nvrmchng/stepper-trinamic/test setup.jpg

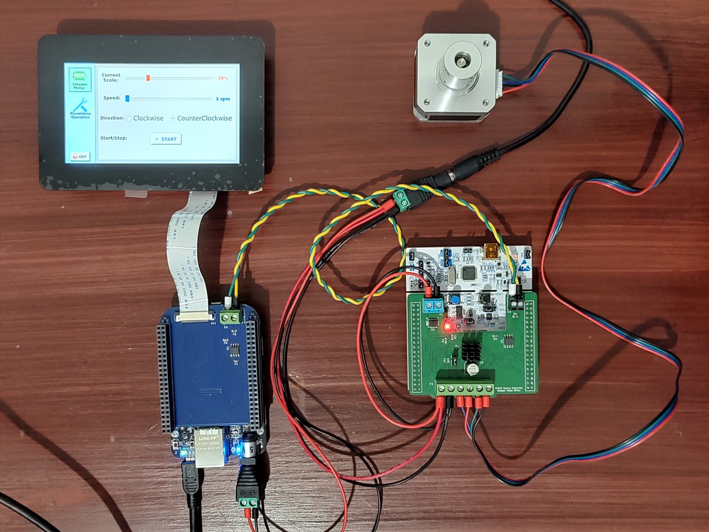
test setup.jpg
