nvrmchng/stepper-trinamic/PCB_Files/Stepper_Motor_Expansion_Brd_revA/Pictures/attached to nucleo brd.jpg

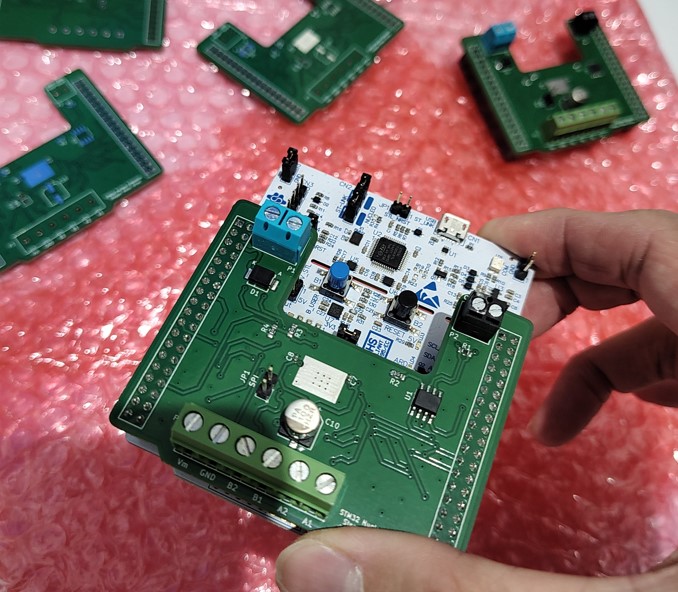
PCB_Files/Stepper_Motor_Expansion_Brd_revA/Pictures/attached to nucleo brd.jpg
