nvrmchng/stepper-trinamic/README.md

# stepper-trinamic
Driving stepper motor with TMC2130 IC from TRINAMIC Motion.
