nvrmchng/stepper-trinamic/PCB_Files/CTP_Display_CANbus_revA/Pics/attached to BBB.jpg

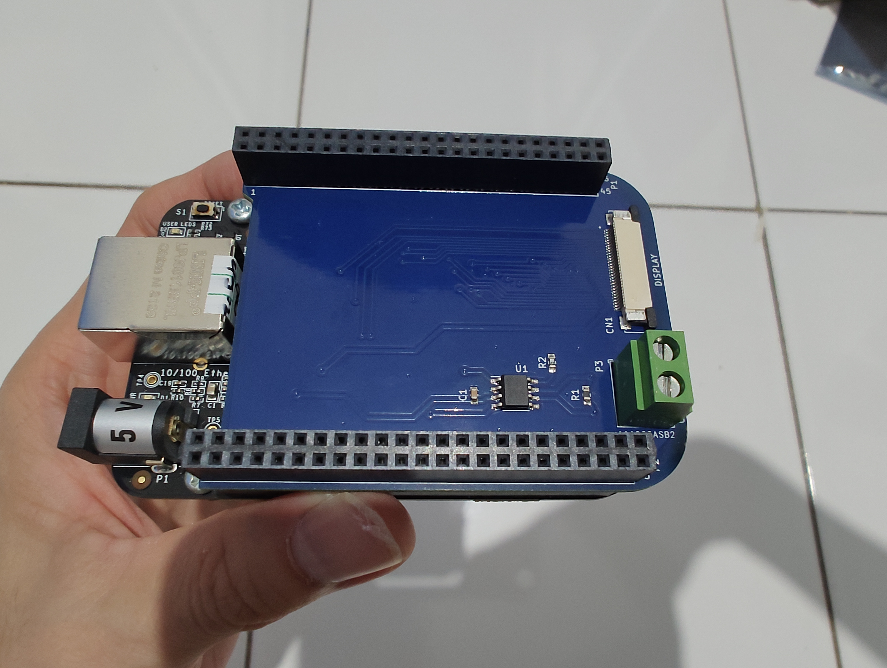
PCB_Files/CTP_Display_CANbus_revA/Pics/attached to BBB.jpg
