nvrmchng/stepper-trinamic/PCB_Files/CTP_Display_CANbus_revA/Pics/top side.jpg

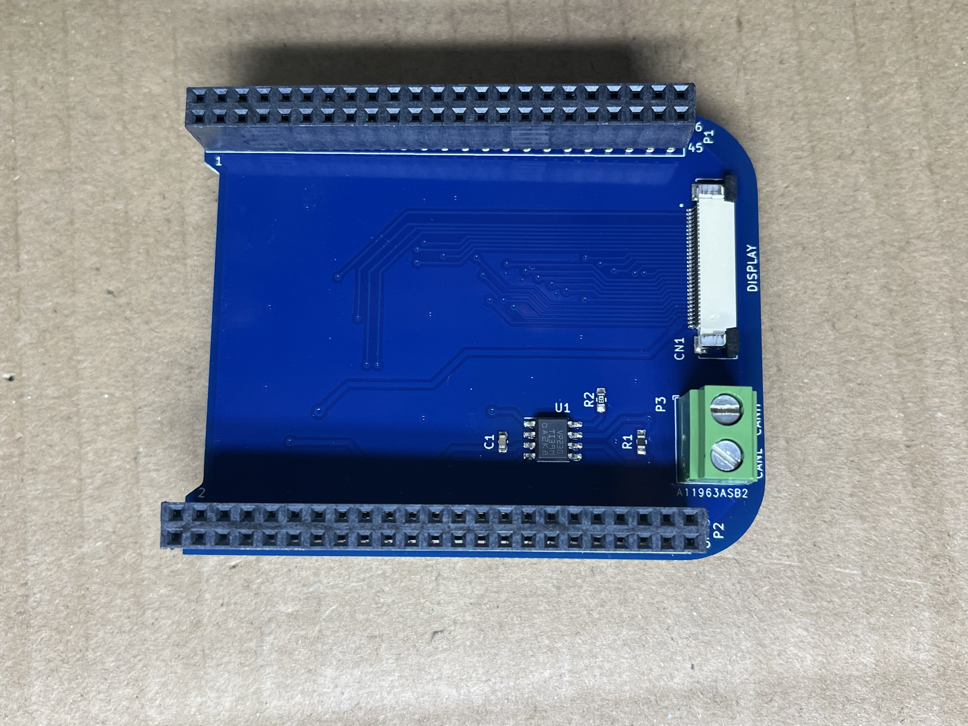
PCB_Files/CTP_Display_CANbus_revA/Pics/top side.jpg
