nvrmchng/stepper-trinamic/PCB_Files/Stepper_Motor_Expansion_Brd_revA/Pictures/bottom side.jpg

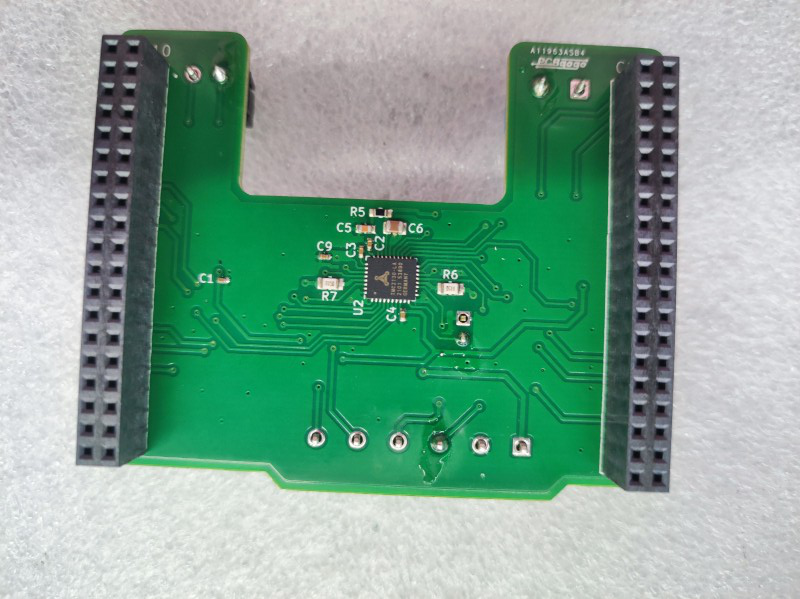
PCB_Files/Stepper_Motor_Expansion_Brd_revA/Pictures/bottom side.jpg
