nvrmchng/stepper-trinamic/PCB_Files/Stepper_Motor_Expansion_Brd_revA/Pictures/top side.jpg

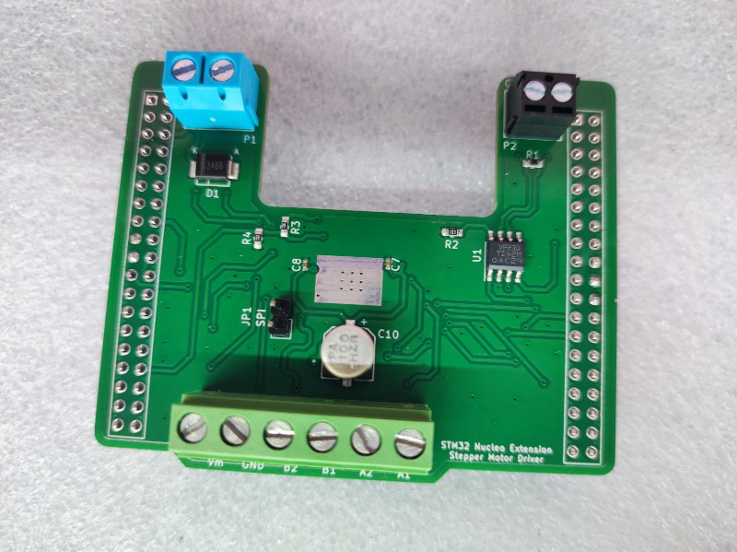
PCB_Files/Stepper_Motor_Expansion_Brd_revA/Pictures/top side.jpg
