nvrmchng/stepper-trinamic/Software ui/Screenshot 01.jpg

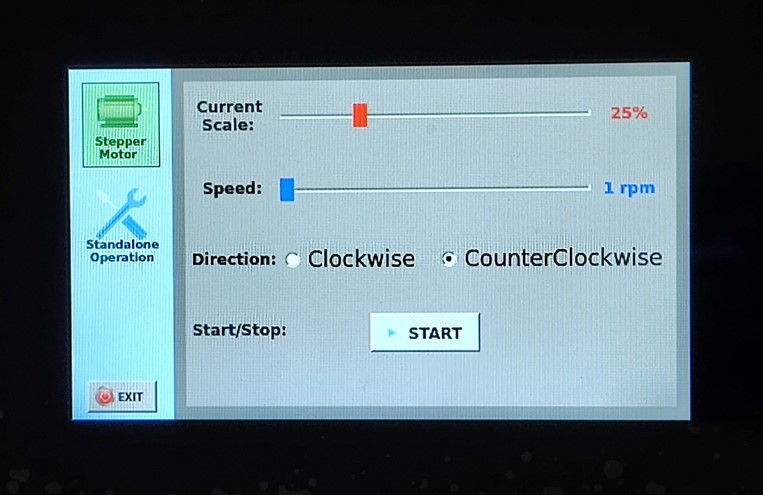
Software ui/Screenshot 01.jpg
