nvrmchng/stepper-trinamic/Software ui/Screenshot 02.jpg

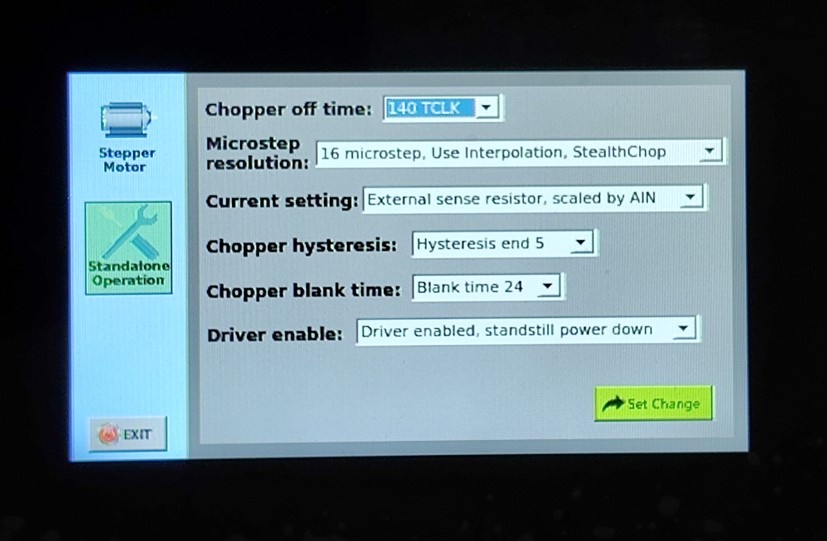
Software ui/Screenshot 02.jpg
