nvrmchng/stepper-trinamic/PCB_Files/CTP_Display_CANbus_revA/BOM_CTP_Display_CANbus_revA.xlsx

 | xxxx xxxx xxxxx xxPCS BOM (Sample Bill of Materials)
Quantity | Designator | Description | Footprint | Manufacturer | Part Number (Manufacturer) | Supplier | Buying Link as reference
1 | C1 | Capacitor Ceramic 0.1uF 50V X7R AEC-Q200 (Automotive) | 0603 (1608 Metric) | TDK Corporation | CGA3E2X7R1H104K080AA | Digikey
1 | CN1 | Conn FFC FPC 30Pos Slide Lock 0.5mm Pitch Top Contact | Surface Mount, Right Angle | Amphenol ICC (FCI) | F32Q-1A7H1-11030 | Digikey
2 | P1, P2 | Female Header Black 46Pos (2x23) 2.54mm Pitch Tin Contact | Through Hole | Samtec Inc. | SSQ-123-03-T-D | Digikey
1 | P3 | Screw Terminal Block Green 2Pos 5mm Pitch Horizontal | Through Hole | Wurth Elektronik | 691137710002 | Digikey
1 | R1 | Res 120 Ohm 1% +-100ppm 0.25W AEC-Q200 (Automotive) | 0603 (1608 Metric) | Vishay Dale | RCS0603120RFKEA | Digikey
1 | R2 | Res 10kOhm 5% +-100ppm 0.1W AEC-Q200 (Automotive) | 0603 (1608 Metric) | YAGEO | AC0603JR-0710KL | Digikey
1 | U1 | IC Transceiver CANbus 1 Mbps Half Duplex 3-3.6V Supply | SOIC-8 (3.9x4.9mm) | Texas Instruments | SN65HVD230DR | Digikey
