nvrmchng/stepper-trinamic/PCB_Files/Stepper_Motor_Expansion_Brd_revA/BOM_Stepper_Motor_Expansion_Brd_revA.xlsx

 | xxxx xxxx xxxxx xxPCS BOM (Sample Bill of Materials)
Quantity | Designator | Description | Footprint | Manufacturer | Part Number (Manufacturer) | Supplier | Buying Link as reference
6 | C1, C3, C4, C7, C8, C9 | Capacitor Ceramic 0.1uF 10% 50V X7R AEC-Q200 (Automotive) | 0402 (1005 Metric) | Murata Electronics | GCM155R71H104KE02D | Digikey | https://www.digikey.com/en/products/detail/murata-electronics/GCM155R71H104KE02D/4903704
1 | C2 | Capacitor Ceramic 22nF 10% 50V X7R AEC-Q200 (Automotive) | 0402 (1005 Metric) | KEMET | C0402C223K5RACAUTO | Digikey | https://www.digikey.com/en/products/detail/kemet/C0402C223K5RACAUTO/7516255
1 | C5 | Capacitor Ceramic 470nF 10% 25V X7R AEC-Q200 (Automotive) | 0603 (1608 Metric) | TDK Corporation | CGA3E3X7R1E474K080AB | Digikey | https://www.digikey.com/en/products/detail/tdk-corporation/CGA3E3X7R1E474K080AB/2672822
1 | C6 | Capacitor Ceramic 4.7uF 10% 25V X7R AEC-Q200 (Automotive) | 0805 (2012 Metric) | TDK Corporation | CGA4J1X7R1E475K125AC | Digikey | https://www.digikey.com/en/products/detail/tdk-corporation/CGA4J1X7R1E475K125AC/2672860
1 | C10 | Aluminium Elco 100uF 20% 50V AEC-Q200 (Automotive) | SMD (6.60mm x 6.60mm) | Chemi-Con | EMZR500ARA101MF80G | Digikey | https://www.digikey.com/en/products/detail/chemi-con/EMZR500ARA101MF80G/5824766
2 | CN7, CN10 | Female Header Black 38Pos (2x19) 2.54mm Pitch Gold | Through Hole | Samtec Inc. | SSW-119-01-F-D | Digikey | https://www.digikey.com/en/products/detail/samtec-inc/SSW-119-01-F-D/7881204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
1 | D1 | Zener Diode 6V 5W | SMB(DO-214AA) | Comchip Technology | CZRB5340B-HF | Digikey | https://www.digikey.com/en/products/detail/comchip-technology/CZRB5340B-HF/10131663
1 | JP1 | Connector Header Male Black Vertical 2Pos 2.54mm Pitch | Through Hole | Wurth Elektronik | 61300211121 | Digikey | https://www.digikey.com/en/products/detail/w%C3%BCrth-elektronik/61300211121/4846823
1 | P1 | Screw Terminal Block Blue 2Pos 5mm Pitch Horizontal | Through Hole | CUI Devices | TB002-500-02BE | Digikey | https://www.digikey.com/en/products/detail/cui-devices/TB002-500-02BE/10064069
1 | P2 | Screw Terminal Block Black 2Pos 3.5mm Pitch Horizontal | Through Hole | On Shore Technology Inc. | OSTTE020104 | Digikey | https://www.digikey.com/en/products/detail/on-shore-technology-inc/OSTTE020104/2351816
1 | P3 | Screw Terminal Block Green 6Pos 5mm Pitch Horizontal | Through Hole | Wurth Elektronik | 691137710006 | Digikey | https://www.digikey.com/en/products/detail/w%C3%BCrth-elektronik/691137710006/6644055
1 | R1 | Res 120 Ohm 1% +-100ppm 0.25W AEC-Q200 (Automotive) | 0603 (1608 Metric) | Vishay Dale | RCS0603120RFKEA | Digikey | https://www.digikey.com/en/products/detail/vishay-dale/RCS0603120RFKEA/5868381
1 | R2 | Res 10kOhm 5% +-100ppm 0.1W AEC-Q200 (Automotive) | 0603 (1608 Metric) | YAGEO | AC0603JR-0710KL | Digikey | https://www.digikey.com/en/products/detail/yageo/AC0603JR-0710KL/2827830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
2 | R3, R4 | Res 20kOhm 1% +-50ppm 1/16W, thin film | 0603 (1608 Metric) | TE Connectivity Passive Product | CPF0603F20KC1 | Digikey | https://www.digikey.com/en/products/detail/te-connectivity-passive-product/CPF0603F20KC1/2384611
1 | R5 | Res 2.2 Ohm 1% +-100ppm 0.25W AEC-Q200 (Automotive) | 0603 (1608 Metric) | Vishay Dale | RCS06032R20FKEA | Digikey | https://www.digikey.com/en/products/detail/vishay-dale/RCS06032R20FKEA/5868187
2 | R6, R7 | Res 150mOhm 1% +-50ppm 0.5W AEC-Q200, current sense | 0805 (2012 Metric) | Susumu | KRL1220E-M-R150-F-T5 | Digikey | https://www.digikey.com/en/products/detail/susumu/KRL1220E-M-R150-F-T5/3737984
1 | U1 | IC Transceiver CANbus 1 Mbps Half Duplex 3-3.6V Supply | SOIC-8 (3.9x4.9mm) | Texas Instruments | SN65HVD230DR | Digikey | https://www.digikey.com/en/products/detail/texas-instruments/SN65HVD230DR/404367
1 | U2 | IC Bipolar Stepper Motor Driver, SPI, STEP, DIR interface | 36-QFN (5x6mm) Exposed Pad | Analog Devices Inc. | TMC2130-LA-T | Digikey | https://www.digikey.com/en/products/detail/analog-devices-inc-maxim-integrated/TMC2130-LA-T/5155766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
