nvrmchng/stepper-trinamic/PCB_Files/CTP_Display_CANbus_revA/CTP_Display_CANbus_revA(Schematic).pdf

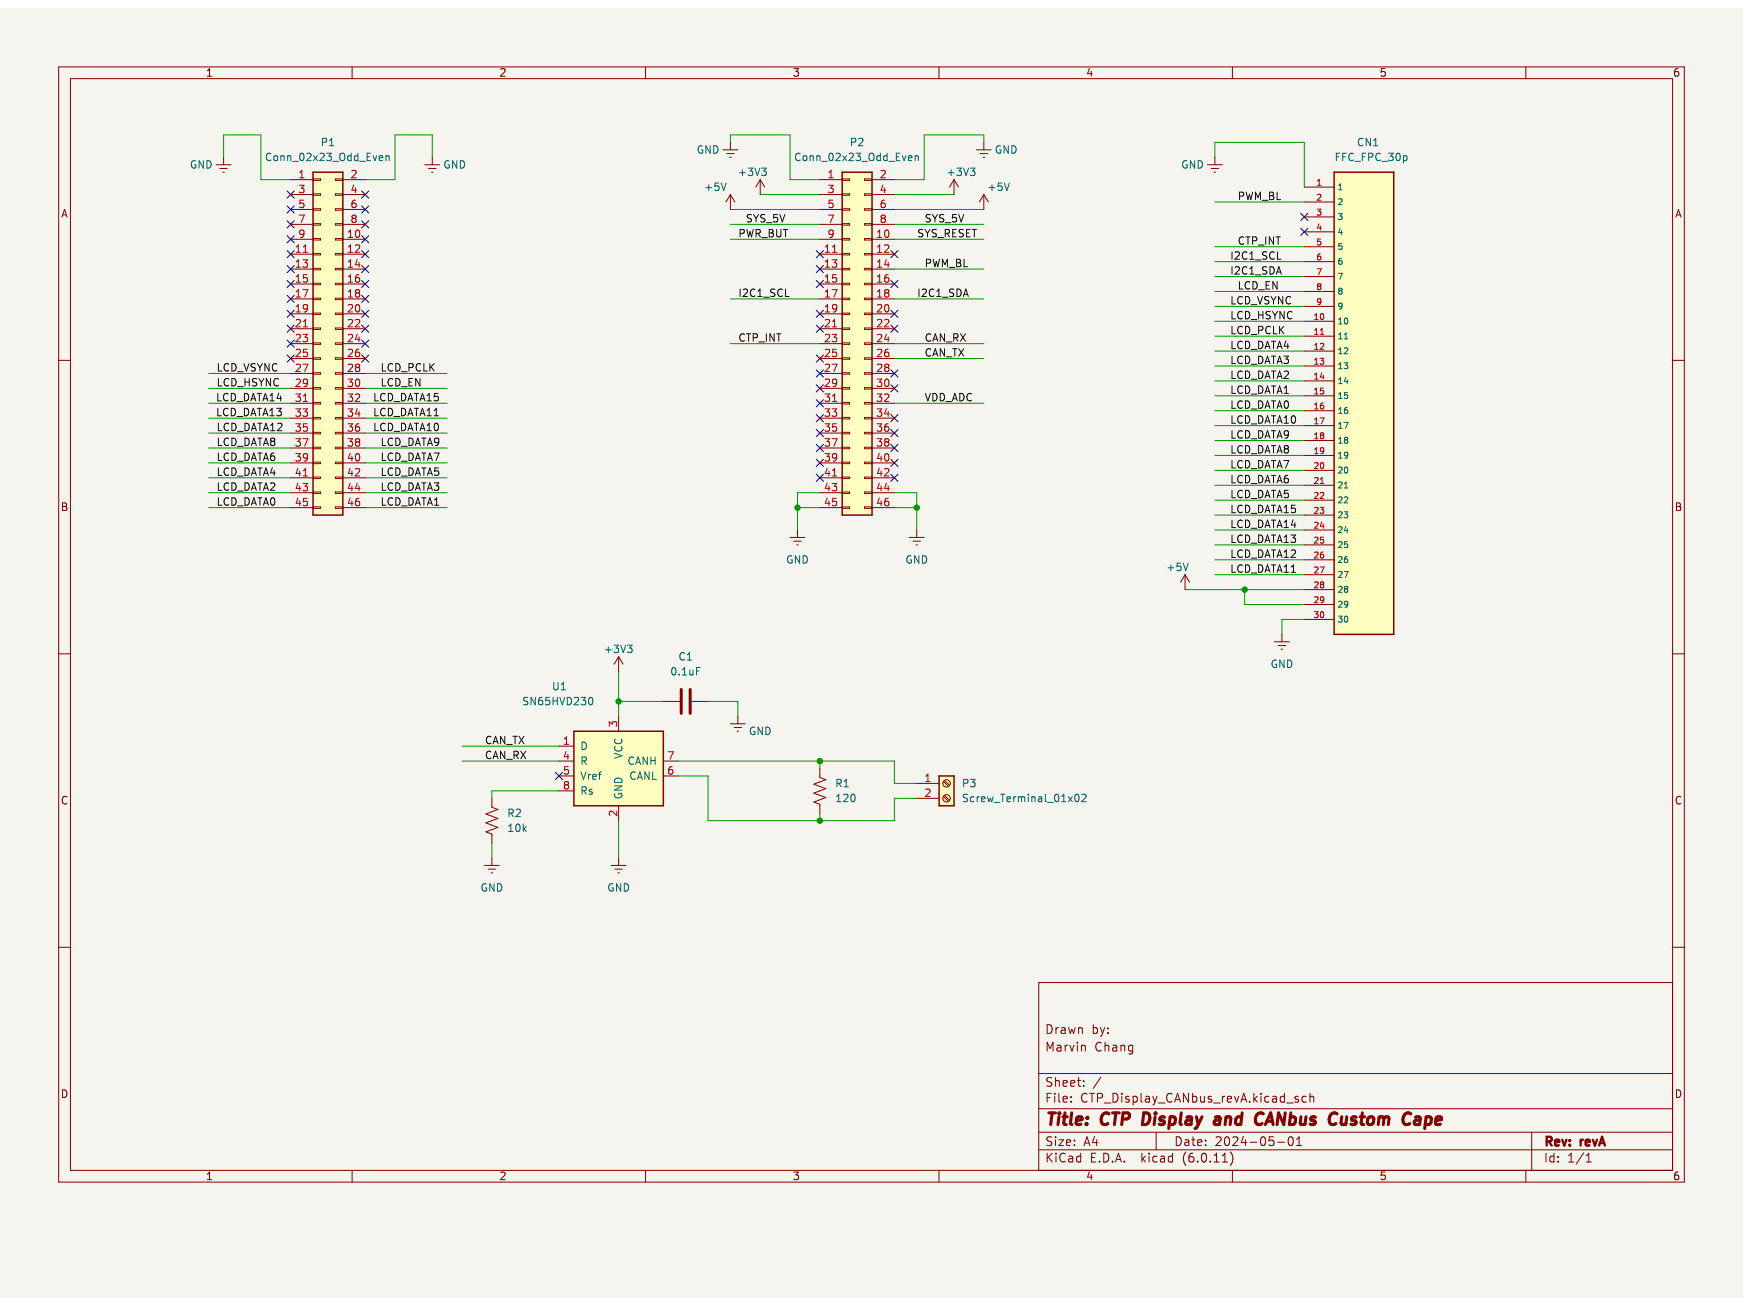
[picture p9: page 1]
