nvrmchng/stepper-trinamic/PCB_Files/Stepper_Motor_Expansion_Brd_revA/Stepper_Motor_Expansion_Brd_revA.pdf

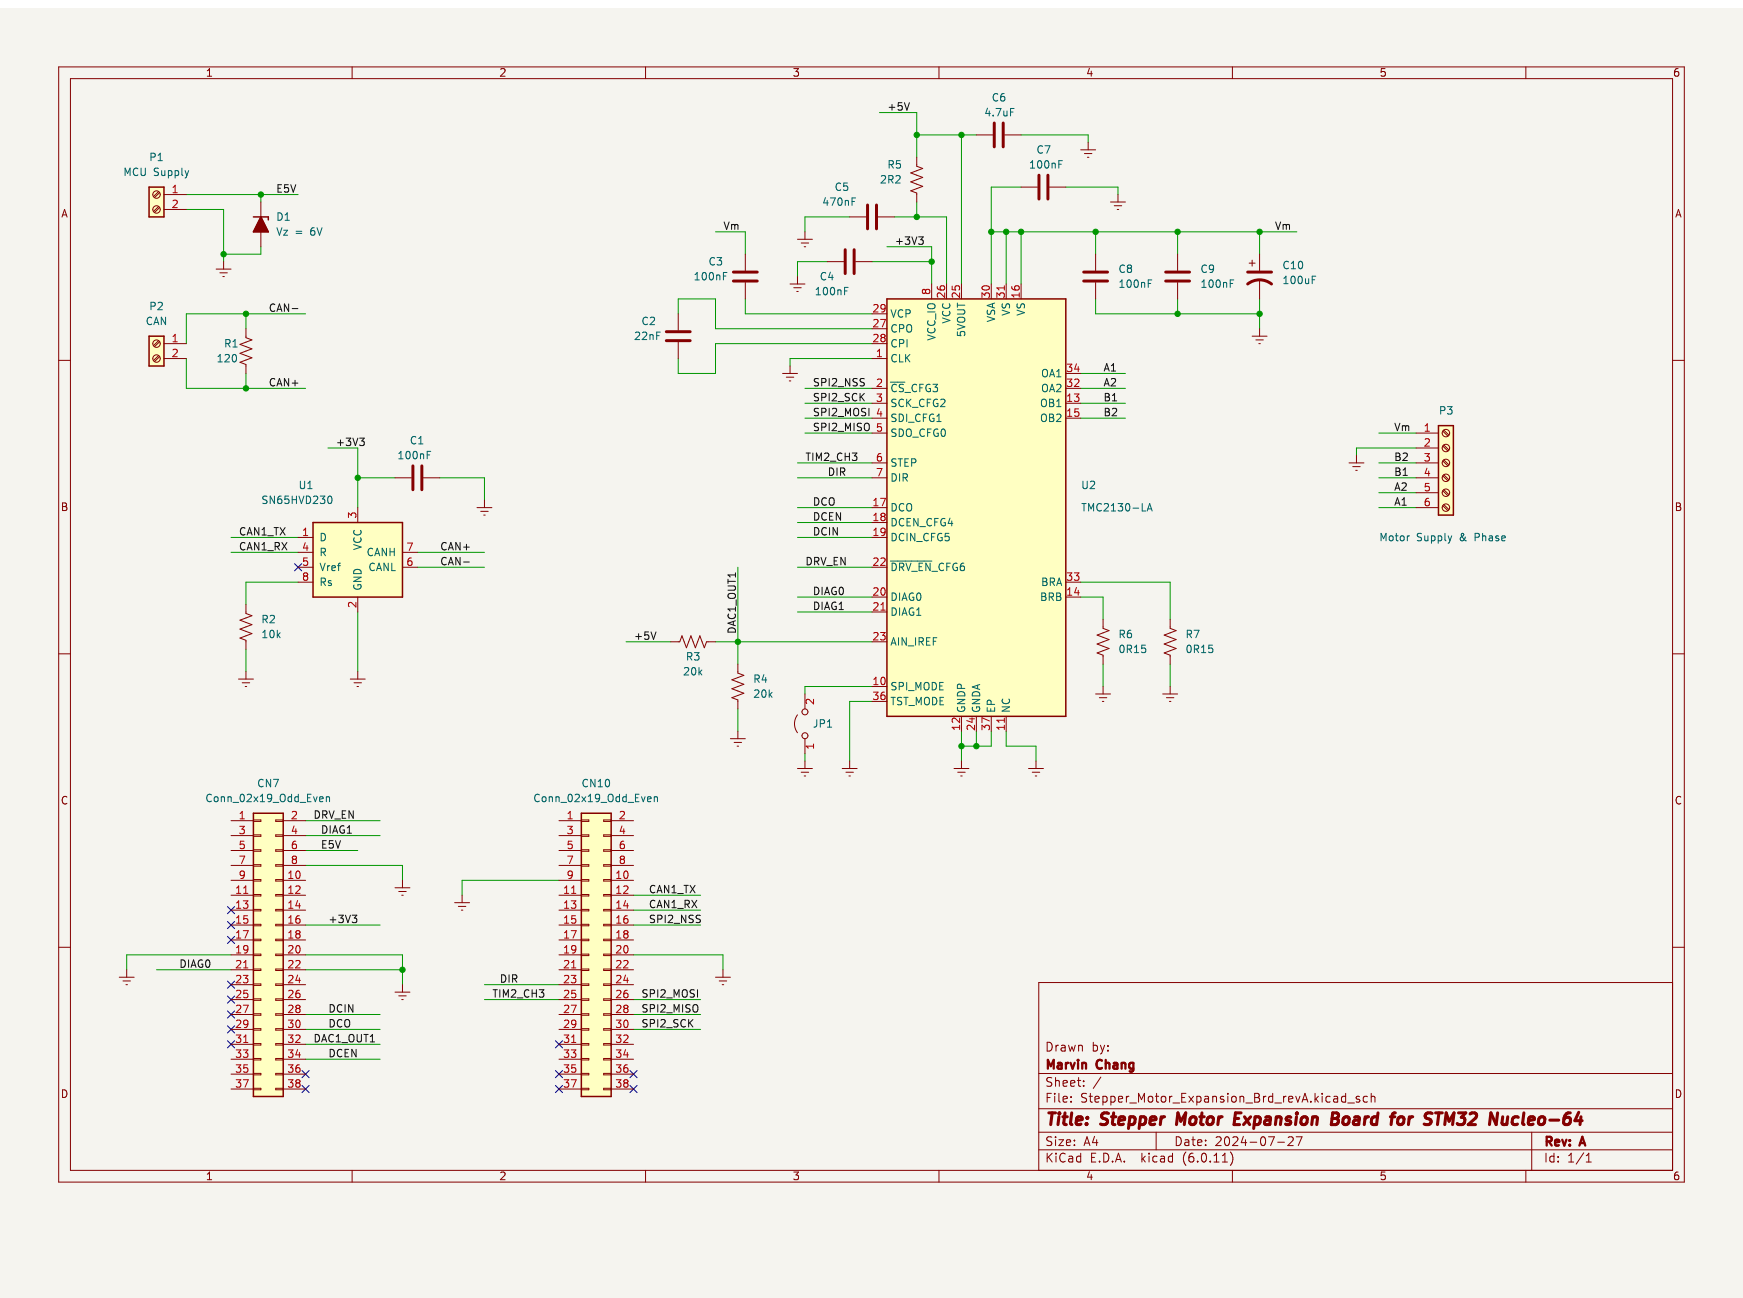
[picture p10: page 1]
