nvrmchng/stepper-trinamic/PCB_Files/CTP_Display_CANbus_revA/CTP_Display_CANbus_revA.kicad_pcb

## KiCad design PCB_Files/CTP_Display_CANbus_revA/CTP_Display_CANbus_revA.kicad_pcb (2024-09-15)

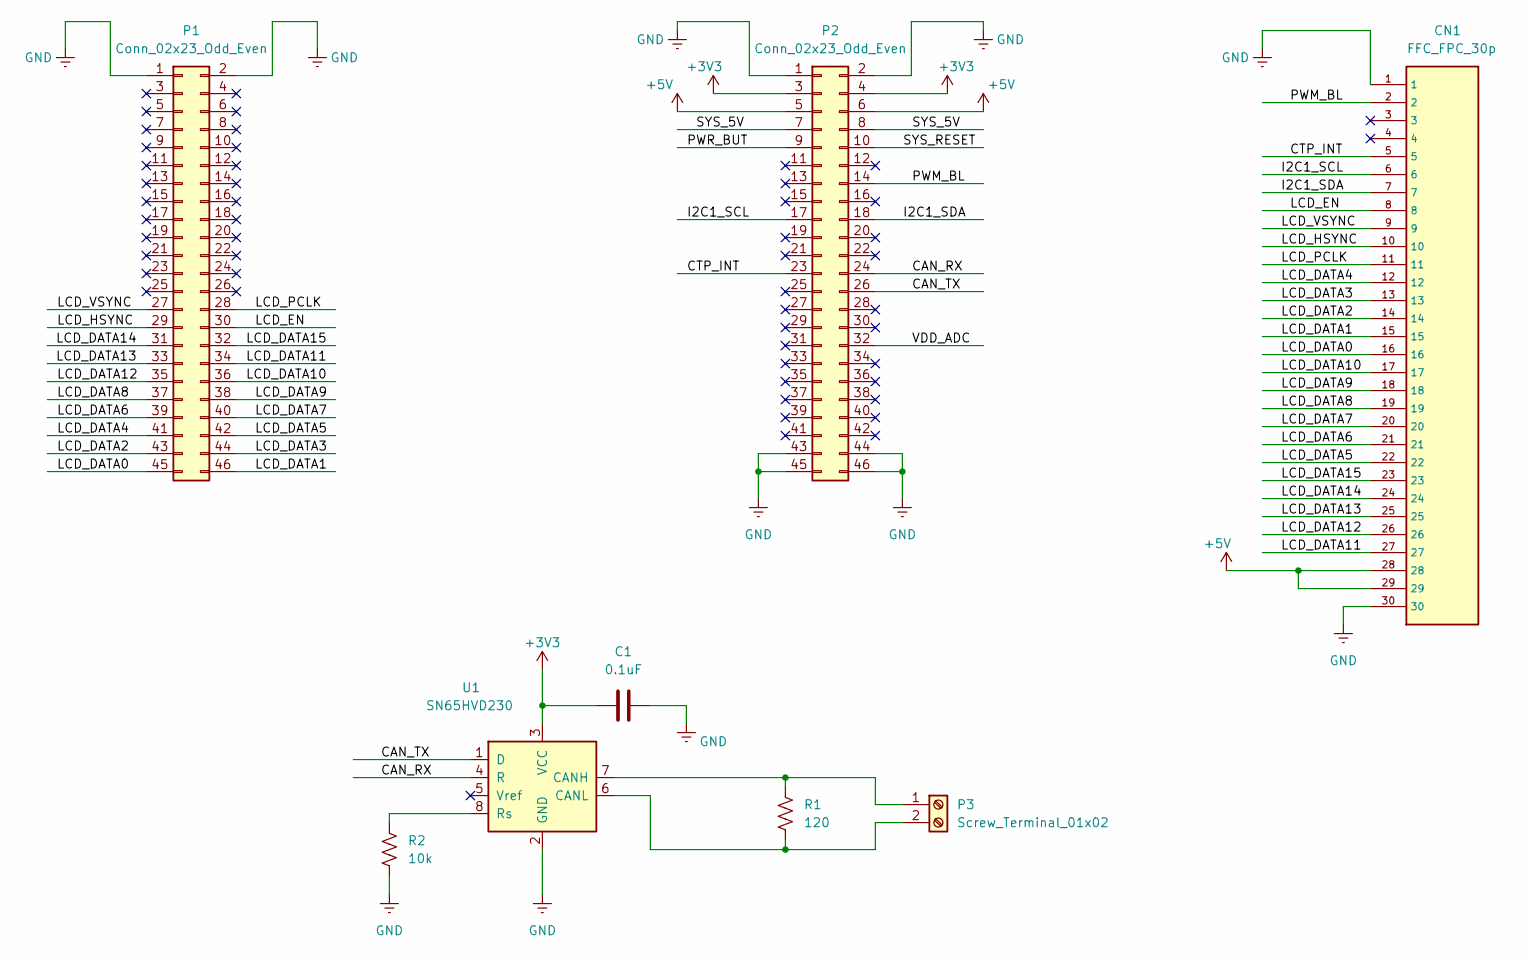
[picture p11: schematic CTP_Display_CANbus_revA.kicad_sch, CTP Display and CANbus Custom Cape]

Parts:
C1: 0.1uF; C_0603_1608Metric
CN1: FFC_FPC_30p; AMPHENOL_F32Q-1A7H1-11030
P1, P2: Conn_02x23_Odd_Even; HEADER_2X23_P2.54MM
P3: Screw_Terminal_01x02; TERM_BLK_2P_5MM_HORIZONTAL
R1: 120; R_0603_1608Metric_Pad0.98x0.95mm_HandSolder
R2: 10k; R_0603_1608Metric_Pad0.98x0.95mm_HandSolder
U1: SN65HVD230; SOIC-8_3.9x4.9mm_P1.27mm

Connections:
+3V3: C1.1, P2.3, P2.4, U1.3 (VCC)
+5V: CN1.28, CN1.29, P2.5, P2.6
/CAN_RX: P2.24, U1.4 (R)
/CAN_TX: P2.26, U1.1 (D)
/CTP_INT: CN1.5, P2.23
/I2C1_SCL: CN1.6, P2.17
/I2C1_SDA: CN1.7, P2.18
/LCD_DATA0: CN1.16, P1.45
/LCD_DATA1: CN1.15, P1.46
/LCD_DATA2: CN1.14, P1.43
/LCD_DATA3: CN1.13, P1.44
/LCD_DATA4: CN1.12, P1.41
/LCD_DATA5: CN1.22, P1.42
/LCD_DATA6: CN1.21, P1.39
/LCD_DATA7: CN1.20, P1.40
/LCD_DATA8: CN1.19, P1.37
/LCD_DATA9: CN1.18, P1.38
/LCD_DATA10: CN1.17, P1.36
/LCD_DATA11: CN1.27, P1.34
/LCD_DATA12: CN1.26, P1.35
/LCD_DATA13: CN1.25, P1.33
/LCD_DATA14: CN1.24, P1.31
/LCD_DATA15: CN1.23, P1.32
/LCD_EN: CN1.8, P1.30
/LCD_HSYNC: CN1.10, P1.29
/LCD_PCLK: CN1.11, P1.28
/LCD_VSYNC: CN1.9, P1.27
/PWM_BL: CN1.2, P2.14
/PWR_BUT: P2.9
/SYS_5V: P2.7, P2.8
/SYS_RESET: P2.10
/VDD_ADC: P2.32
GNDREF: C1.2, CN1.1, CN1.30, CN1.S1, CN1.S2, P1.1, P1.2, P2.1, P2.2, P2.43, P2.44, P2.45, P2.46, R2.2, U1.2 (GND)
unnamed: P3.1, R1.1, U1.7 (CANH)
unnamed: P3.2, R1.2, U1.6 (CANL)
unnamed: R2.1, U1.8 (Rs)

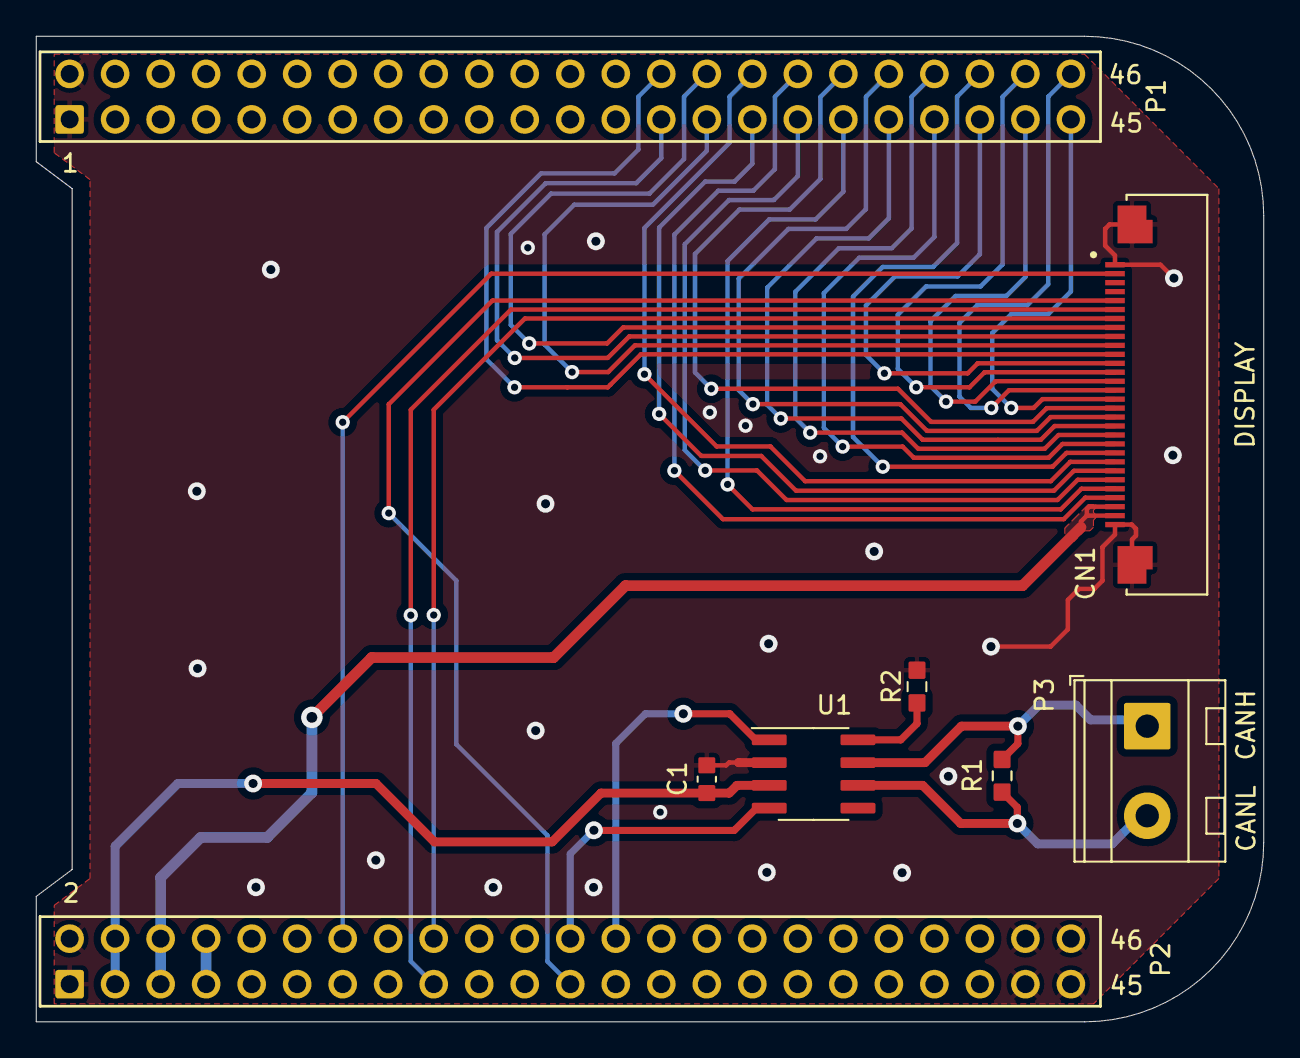
[picture p12: board CTP_Display_CANbus_revA.kicad_pcb from above]

Board: 2 copper layers, 68.5 x 55.0 mm, 8 parts (0 on the bottom side), 33 nets.
