nvrmchng/stepper-trinamic/PCB_Files/Stepper_Motor_Expansion_Brd_revA/Stepper_Motor_Expansion_Brd_revA.kicad_pcb

## KiCad design PCB_Files/Stepper_Motor_Expansion_Brd_revA/Stepper_Motor_Expansion_Brd_revA.kicad_pcb (2024-09-15)

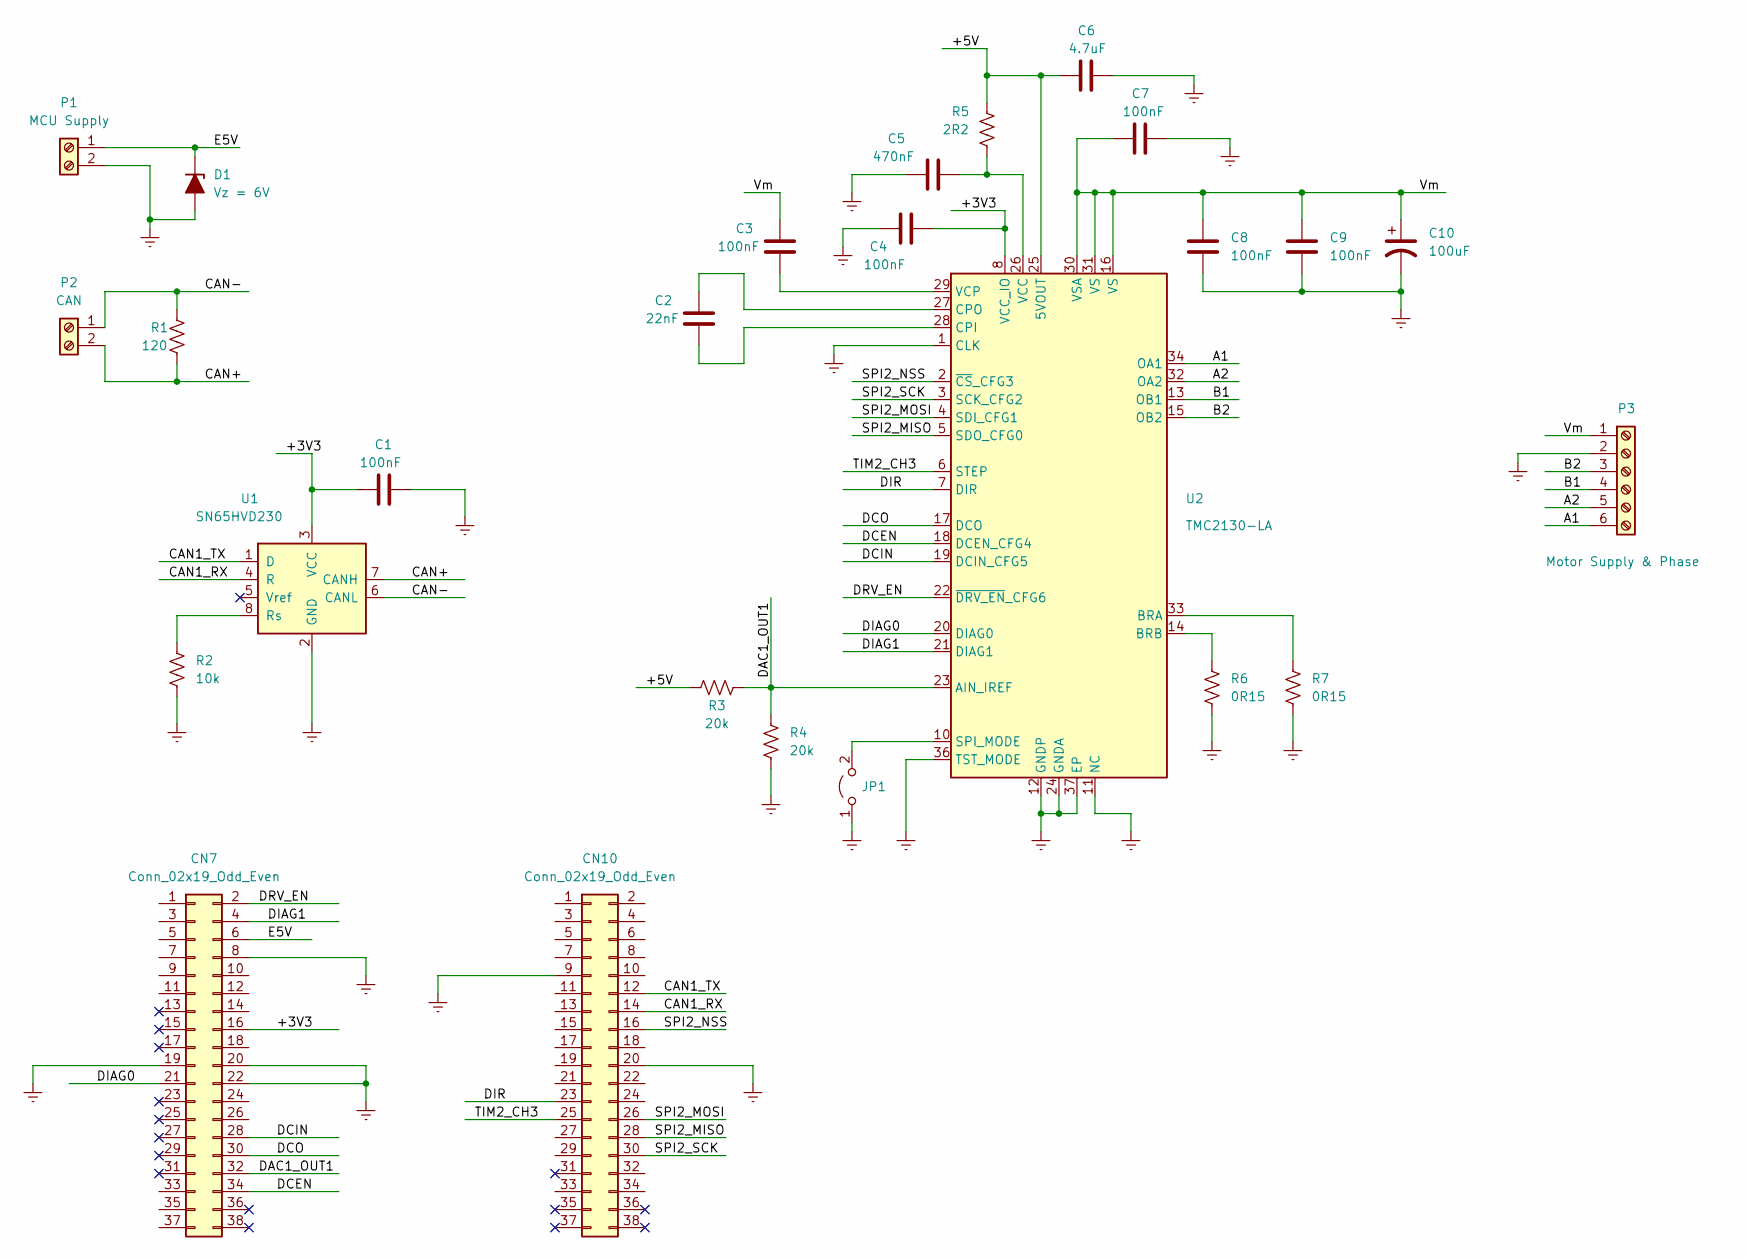
[picture p13: schematic Stepper_Motor_Expansion_Brd_revA.kicad_sch, Stepper Motor Expansion Board for STM32 Nucleo-64]

Parts:
C1, C3, C4, C7, C8, C9: 100nF; C_0402_1005Metric
C2: 22nF; C_0402_1005Metric
C5: 470nF; C_0603_1608Metric
C6: 4.7uF; C_0805_2012Metric
C10: 100uF; CP_Elec_6.3x7.7(EMZR500ARA101MF80G)
CN7, CN10: Conn_02x19_Odd_Even; Header_2x19_P2.54mm_Vertical(SAMTEC_SSW-119-01-F-D)
D1: Vz = 6V; D_SMB(DO-214AA)
JP1: Jumper_2_Open; PinHeader_1x02_P2.54mm_Vertical
P1: MCU Supply; TerminalBlock-2_P5.00mm(TB002-500-02BE)
P2: CAN; TerminalBlock-2_P3.50mm(OSTTE020104)
P3: Motor Supply & Phase; TerminalBlock_Wuerth-6_P5.00mm(1137710006)
R1: 120; R_0603_1608Metric_Pad0.98x0.95mm_HandSolder
R2: 10k; R_0603_1608Metric_Pad0.98x0.95mm_HandSolder
R3, R4: 20k; R_0603_1608Metric_Pad0.98x0.95mm_HandSolder
R5: 2R2; R_0603_1608Metric_Pad0.98x0.95mm_HandSolder
R6, R7: 0R15; R_0805_2012Metric_Pad1.20x1.40mm_HandSolder
U1: SN65HVD230; SOIC-8_3.9x4.9mm_P1.27mm
U2: TMC2130-LA; QFN-36-1EP_5x6mm_P0.5mm_EP3.6x4.1mm

Connections:
/+3V3: C1.2, C4.1, CN7.16, U1.3 (VCC), U2.8 (VCC_IO)
/+5V: C6.1, R3.1, R5.1, U2.25 (5VOUT)
/A1: P3.6, U2.34 (OA1)
/A2: P3.5, U2.32 (OA2)
/B1: P3.4, U2.13 (OB1)
/B2: P3.3, U2.15 (OB2)
/CAN1_RX: CN10.14, U1.4 (R)
/CAN1_TX: CN10.12, U1.1 (D)
/CAN+: P2.2, R1.2, U1.7 (CANH)
/CAN-: P2.1, R1.1, U1.6 (CANL)
/DAC1_OUT1: CN7.32, R3.2, R4.1, U2.23 (AIN_IREF)
/DCEN: CN7.34, U2.18 (DCEN_CFG4)
/DCIN: CN7.28, U2.19 (DCIN_CFG5)
/DCO: CN7.30, U2.17 (DCO)
/DIAG0: CN7.21, U2.20 (DIAG0)
/DIAG1: CN7.4, U2.21 (DIAG1)
/DIR: CN10.23, U2.7 (DIR)
/DRV_EN: CN7.2, U2.22 (~DRV_EN_CFG6)
/E5V: CN7.6, D1.1 (K), P1.1
/SPI2_MISO: CN10.28, U2.5 (SDO_CFG0)
/SPI2_MOSI: CN10.26, U2.4 (SDI_CFG1)
/SPI2_NSS: CN10.16, U2.2 (~CS_CFG3)
/SPI2_SCK: CN10.30, U2.3 (SCK_CFG2)
/TIM2_CH3: CN10.25, U2.6 (STEP)
/Vm: C3.2, C7.1, C8.1, C9.1, C10.1, P3.1, U2.16 (VS), U2.30 (VSA), U2.31 (VS)
GND: C1.1, C4.2, C5.2, C6.2, C7.2, C8.2, C9.2, C10.2, CN7.8, CN7.19, CN7.20, CN7.22, CN10.9, CN10.20, D1.2 (A), JP1.1 (A), P1.2, P3.2, R2.2, R4.2, R6.2, R7.2, U1.2 (GND), U2.1 (CLK), U2.11 (NC), U2.12 (GNDP), U2.24 (GNDA), U2.35 (GNDP), U2.36 (TST_MODE), U2.37 (EP)
unnamed: C2.1, U2.28 (CPI)
unnamed: C2.2, U2.27 (CPO)
unnamed: C3.1, U2.29 (VCP)
unnamed: C5.1, R5.2, U2.26 (VCC)
unnamed: JP1.2 (B), U2.10 (SPI_MODE)
unnamed: R2.1, U1.8 (Rs)
unnamed: R6.1, U2.14 (BRB)
unnamed: R7.1, U2.33 (BRA)

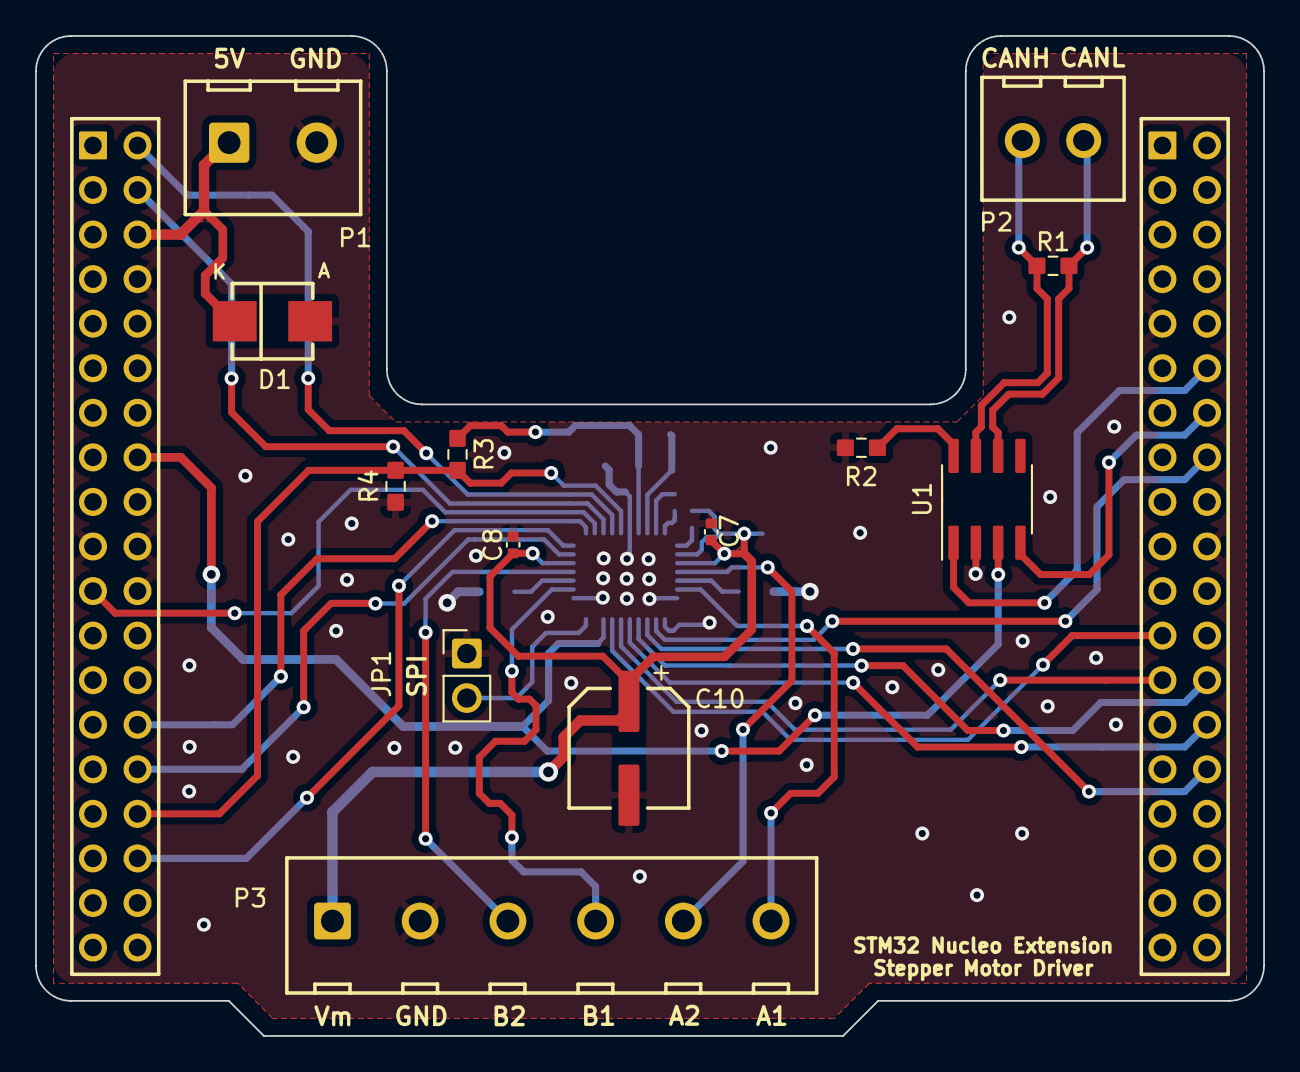
[picture p14: board Stepper_Motor_Expansion_Brd_revA.kicad_pcb from above]

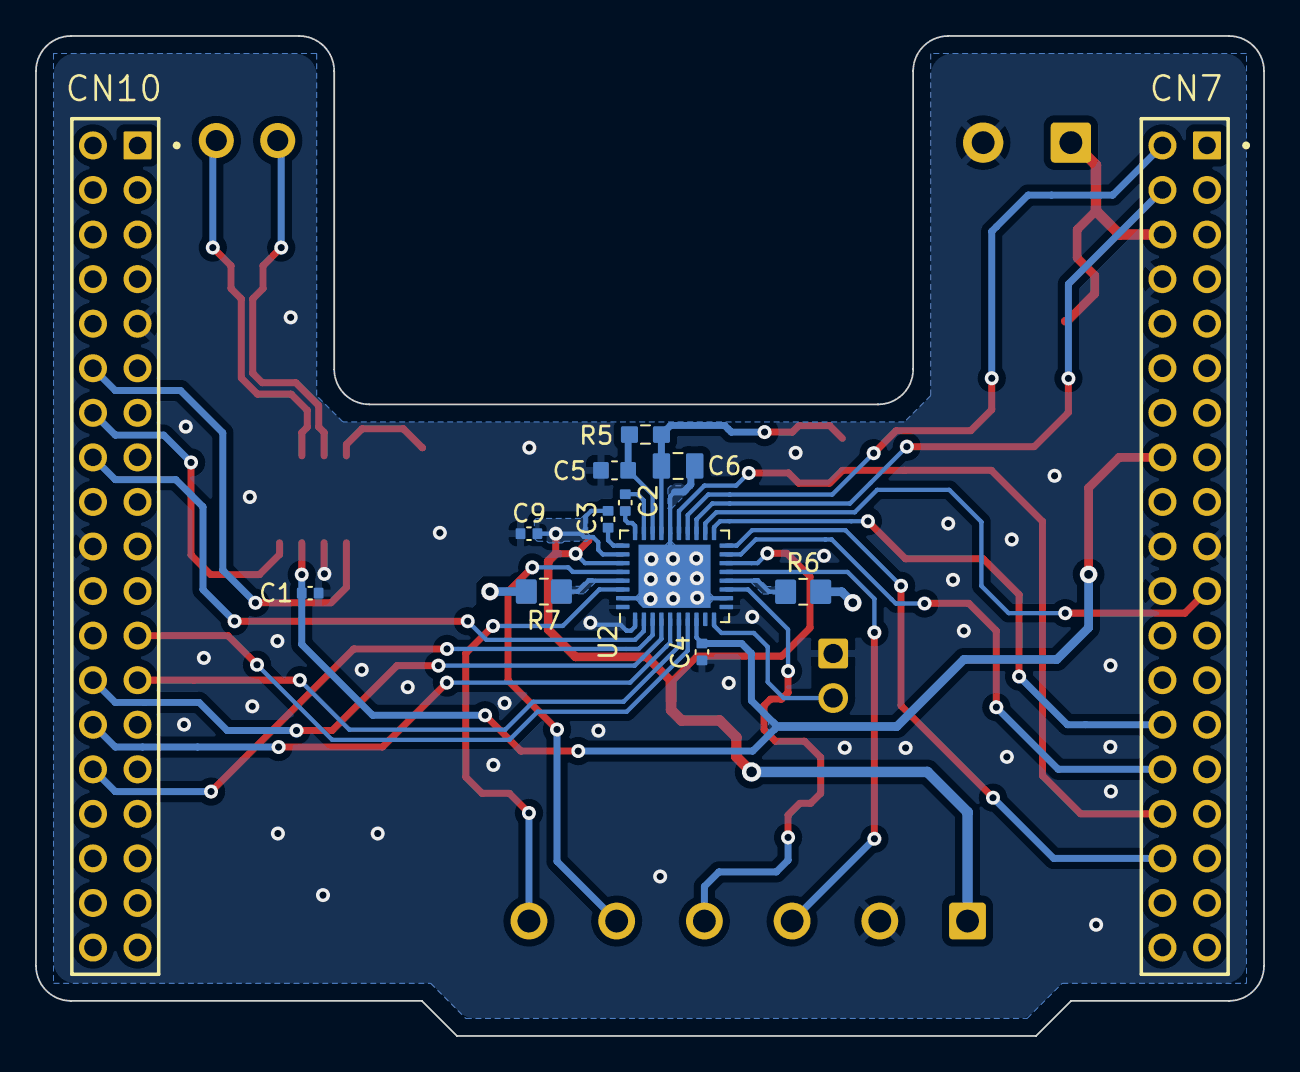
[picture p15: board Stepper_Motor_Expansion_Brd_revA.kicad_pcb from below]

Board: 2 copper layers, 70.0 x 57.0 mm, 26 parts (13 on the bottom side), 34 nets.
