nvrmchng/stepper-trinamic/Firmware/Standalone_Test_2/Core/Src/main.c

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
/* Includes ------------------------------------------------------------------*/
#include "main.h"
#include "cmsis_os.h"

CAN_HandleTypeDef hcan1;

DAC_HandleTypeDef hdac1;

TIM_HandleTypeDef htim2;

UART_HandleTypeDef huart2;

/* Definitions for defaultTask */
osThreadId_t defaultTaskHandle;
const osThreadAttr_t defaultTask_attributes = {
  .name = "defaultTask",
  .stack_size = 128 * 4,
  .priority = (osPriority_t) osPriorityNormal,
};
/* Definitions for DeferredTask1 */
osThreadId_t DeferredTask1Handle;
const osThreadAttr_t DeferredTask1_attributes = {
  .name = "DeferredTask1",
  .stack_size = 128 * 4,
  .priority = (osPriority_t) osPriorityAboveNormal,
};
/* Definitions for DeferredTask2 */
osThreadId_t DeferredTask2Handle;
const osThreadAttr_t DeferredTask2_attributes = {
  .name = "DeferredTask2",
  .stack_size = 128 * 4,
  .priority = (osPriority_t) osPriorityAboveNormal3,
};
/* Definitions for DeferredTask3 */
osThreadId_t DeferredTask3Handle;
const osThreadAttr_t DeferredTask3_attributes = {
  .name = "DeferredTask3",
  .stack_size = 128 * 4,
  .priority = (osPriority_t) osPriorityAboveNormal,
};
/* Definitions for DeferredTask4 */
osThreadId_t DeferredTask4Handle;
const osThreadAttr_t DeferredTask4_attributes = {
  .name = "DeferredTask4",
  .stack_size = 128 * 4,
  .priority = (osPriority_t) osPriorityAboveNormal3,
};
/* Definitions for myBinarySem01 */
osSemaphoreId_t myBinarySem01Handle;
const osSemaphoreAttr_t myBinarySem01_attributes = {
  .name = "myBinarySem01"
};
/* Definitions for myBinarySem02 */
osSemaphoreId_t myBinarySem02Handle;
const osSemaphoreAttr_t myBinarySem02_attributes = {
  .name = "myBinarySem02"
};
/* Definitions for myBinarySem03 */
osSemaphoreId_t myBinarySem03Handle;
const osSemaphoreAttr_t myBinarySem03_attributes = {
  .name = "myBinarySem03"
};
/* Definitions for myBinarySem04 */
osSemaphoreId_t myBinarySem04Handle;
const osSemaphoreAttr_t myBinarySem04_attributes = {
  .name = "myBinarySem04"
};
/* USER CODE BEGIN PV */
CAN_FilterTypeDef Rx_Filter_0, Rx_Filter_1;
CAN_RxHeaderTypeDef CAN_Rx_Header_Id1, CAN_Rx_Header_Id2;
uint8_t CAN_Rx_Data_Id1[8] = {'\0','\0','\0','\0','\0','\0','\0','\0'};
uint8_t CAN_Rx_Data_Id2[8] = {'\0','\0','\0','\0','\0','\0','\0','\0'};
/* USER CODE END PV */

void SystemClock_Config(void);
static void MX_GPIO_Init(void);
static void MX_USART2_UART_Init(void);
static void MX_TIM2_Init(void);
static void MX_CAN1_Init(void);
static void MX_DAC1_Init(void);
void StartDefaultTask(void *argument);
void Interpret_CAN_Msg_Id1(void *argument);
void Update_Stepper_Motor_Task(void *argument);
void Interpret_CAN_Msg_Id2(void *argument);
void Update_Standalone_Op_Task(void *argument);

/* USER CODE BEGIN PFP */
void Read_CAN_Frame_From_FIFO0(CAN_HandleTypeDef *hcan);
void Read_CAN_Frame_From_FIFO1(CAN_HandleTypeDef *hcan);
/* USER CODE END PFP */

/**
  * @brief  The application entry point.
  * @retval int
  */
int main(void)
{

  /* MCU Configuration--------------------------------------------------------*/

  /* Reset of all peripherals, Initializes the Flash interface and the Systick. */
  HAL_Init();

  /* Configure the system clock */
  SystemClock_Config();

  /* Initialize all configured peripherals */
  MX_GPIO_Init();
  MX_USART2_UART_Init();
  MX_TIM2_Init();
  MX_CAN1_Init();
  MX_DAC1_Init();
  /* USER CODE BEGIN 2 */
  HAL_CAN_Start(&hcan1);
  HAL_DAC_Start(&hdac1, DAC_CHANNEL_1);
  Init_Stepper_Motor();
  /* USER CODE END 2 */

  /* Init scheduler */
  osKernelInitialize();

  /* USER CODE BEGIN RTOS_MUTEX */
  /* add mutexes, ... */
  /* USER CODE END RTOS_MUTEX */

  /* Create the semaphores(s) */
  /* creation of myBinarySem01 */
  myBinarySem01Handle = osSemaphoreNew(1, 0, &myBinarySem01_attributes);

  /* creation of myBinarySem02 */
  myBinarySem02Handle = osSemaphoreNew(1, 0, &myBinarySem02_attributes);

  /* creation of myBinarySem03 */
  myBinarySem03Handle = osSemaphoreNew(1, 0, &myBinarySem03_attributes);

  /* creation of myBinarySem04 */
  myBinarySem04Handle = osSemaphoreNew(1, 0, &myBinarySem04_attributes);

  /* USER CODE BEGIN RTOS_SEMAPHORES */
  /* add semaphores, ... */
  /* USER CODE END RTOS_SEMAPHORES */

  /* USER CODE BEGIN RTOS_TIMERS */
  /* start timers, add new ones, ... */
  /* USER CODE END RTOS_TIMERS */

  /* USER CODE BEGIN RTOS_QUEUES */
  /* add queues, ... */
  /* USER CODE END RTOS_QUEUES */

  /* Create the thread(s) */
  /* creation of defaultTask */
  defaultTaskHandle = osThreadNew(StartDefaultTask, NULL, &defaultTask_attributes);

  /* creation of DeferredTask1 */
  DeferredTask1Handle = osThreadNew(Interpret_CAN_Msg_Id1, NULL, &DeferredTask1_attributes);

  /* creation of DeferredTask2 */
  DeferredTask2Handle = osThreadNew(Update_Stepper_Motor_Task, NULL, &DeferredTask2_attributes);

  /* creation of DeferredTask3 */
  DeferredTask3Handle = osThreadNew(Interpret_CAN_Msg_Id2, NULL, &DeferredTask3_attributes);

  /* creation of DeferredTask4 */
  DeferredTask4Handle = osThreadNew(Update_Standalone_Op_Task, NULL, &DeferredTask4_attributes);

  /* USER CODE BEGIN RTOS_THREADS */
  /* add threads, ... */
  /* USER CODE END RTOS_THREADS */

  /* USER CODE BEGIN RTOS_EVENTS */
  /* add events, ... */
  /* USER CODE END RTOS_EVENTS */

  /* Start scheduler */
  osKernelStart();

  /* We should never get here as control is now taken by the scheduler */

  /* Infinite loop */
  /* USER CODE BEGIN WHILE */
  while (1)
  {
    /* USER CODE END WHILE */

    /* USER CODE BEGIN 3 */
  }
  /* USER CODE END 3 */
}

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
/* USER CODE BEGIN 4 */
void Read_CAN_Frame_From_FIFO0(CAN_HandleTypeDef *hcan)
{
	HAL_CAN_GetRxMessage(&hcan1, CAN_RX_FIFO0, &CAN_Rx_Header_Id1, CAN_Rx_Data_Id1);
	if(CAN_Rx_Header_Id1.DLC >= 4){
		osSemaphoreRelease(myBinarySem01Handle);
	}// else something is wrong, don't proceed with interpreting message
}

void Read_CAN_Frame_From_FIFO1(CAN_HandleTypeDef *hcan)
{
	HAL_CAN_GetRxMessage(&hcan1, CAN_RX_FIFO1, &CAN_Rx_Header_Id2, CAN_Rx_Data_Id2);
	if(CAN_Rx_Header_Id2.DLC >= 6){
		osSemaphoreRelease(myBinarySem03Handle);
	}// else something is wrong, don't proceed with interpreting message
}
/* USER CODE END 4 */

/* USER CODE BEGIN Header_StartDefaultTask */
/**
  * @brief  Function implementing the defaultTask thread.
  * @param  argument: Not used
  * @retval None
  */
/* USER CODE END Header_StartDefaultTask */
void StartDefaultTask(void *argument)
{
  /* USER CODE BEGIN 5 */
  /* Infinite loop */
  for(;;)
  {
    osDelay(osWaitForever);
  }
  /* USER CODE END 5 */
}

/* USER CODE BEGIN Header_Interpret_CAN_Msg_Id1 */
/**
* @brief Function implementing the DeferredTask1 thread.
* @param argument: Not used
* @retval None
*/
/* USER CODE END Header_Interpret_CAN_Msg_Id1 */
void Interpret_CAN_Msg_Id1(void *argument)
{
  /* USER CODE BEGIN Interpret_CAN_Msg_Id1 */
  uint8_t msg_correct_cnt;	// if more message need to be processed I think better use bitwise masking than count
  /* Infinite loop */
  for(;;)
  {
	  osSemaphoreAcquire(myBinarySem01Handle, osWaitForever);
	  // interpret here and fill up hstepmtr
	  msg_correct_cnt = 0;
	  if((CAN_Rx_Data_Id1[0] == STEPPER_MOTOR_STOP) || (CAN_Rx_Data_Id1[0] == STEPPER_MOTOR_START)){
		  msg_correct_cnt++;
		  hstepmtr.run_state = CAN_Rx_Data_Id1[0];
	  }
	  if((CAN_Rx_Data_Id1[1] == MOTOR_DIRECTION_CCW) || (CAN_Rx_Data_Id1[1] == MOTOR_DIRECTION_CW)){
		  msg_correct_cnt++;
		  hstepmtr.direction = CAN_Rx_Data_Id1[1];
	  }
	  if((CAN_Rx_Data_Id1[2] >= MIN_CURRENT_SCALE) && (CAN_Rx_Data_Id1[2] <= MAX_CURRENT_SCALE)){
		  msg_correct_cnt++;
		  hstepmtr.current_scale = CAN_Rx_Data_Id1[2];
	  }
	  if((CAN_Rx_Data_Id1[3] >= MIN_MOTOR_SPEED_RPM) && (CAN_Rx_Data_Id1[3] <= MAX_MOTOR_SPEED_RPM)){
		  msg_correct_cnt++;
		  hstepmtr.speed = CAN_Rx_Data_Id1[3];
	  }
	  if(msg_correct_cnt > 0){
		  osSemaphoreRelease(myBinarySem02Handle);	// pass to the next task
	  }// if 0 (none) of the messages are correct, don't proceed
  }
  /* USER CODE END Interpret_CAN_Msg_Id1 */
}

/* USER CODE BEGIN Header_Update_Stepper_Motor_Task */
/**
* @brief Function implementing the DeferredTask2 thread.
* @param argument: Not used
* @retval None
*/
/* USER CODE END Header_Update_Stepper_Motor_Task */
void Update_Stepper_Motor_Task(void *argument)
{
  /* USER CODE BEGIN Update_Stepper_Motor_Task */
  /* Infinite loop */
  for(;;)
  {
	  osSemaphoreAcquire(myBinarySem02Handle, osWaitForever);
	  Update_Stepper_Motor_Operation();
  }
  /* USER CODE END Update_Stepper_Motor_Task */
}

/* USER CODE BEGIN Header_Interpret_CAN_Msg_Id2 */
/**
* @brief Function implementing the DeferredTask3 thread.
* @param argument: Not used
* @retval None
*/
/* USER CODE END Header_Interpret_CAN_Msg_Id2 */
void Interpret_CAN_Msg_Id2(void *argument)
{
  /* USER CODE BEGIN Interpret_CAN_Msg_Id2 */
  uint8_t msg_correct_cnt;
  /* Infinite loop */
  for(;;)
  {
	  osSemaphoreAcquire(myBinarySem03Handle, osWaitForever);
	  // interpret here and fill up hstepmtr
	  msg_correct_cnt = 0;
	  
	  if(CAN_Rx_Data_Id2[0] <= TOFF_332TCLK)
	  {		msg_correct_cnt++; hstepmtr.standalone_cfg.chopper_off_time = CAN_Rx_Data_Id2[0];	}
	  
	  hstepmtr.standalone_cfg.chopper_mode = CAN_Rx_Data_Id2[1] & MODE_STEALTHCHOP;
	  hstepmtr.standalone_cfg.interpolation = CAN_Rx_Data_Id2[1] & USE_INTERPOLATION;
	  CAN_Rx_Data_Id2[1] &= (MICROSTEP_16 | QUARTERSTEP_4 | HALFSTEP_2 | FULLSTEP_1);
	  if((CAN_Rx_Data_Id2[1] == MICROSTEP_16) || (CAN_Rx_Data_Id2[1] == QUARTERSTEP_4) || 
		 (CAN_Rx_Data_Id2[1] == HALFSTEP_2) || (CAN_Rx_Data_Id2[1] == FULLSTEP_1))
	  {		msg_correct_cnt++; hstepmtr.standalone_cfg.microstep_res = CAN_Rx_Data_Id2[1];	}
	  
	  if(CAN_Rx_Data_Id2[2] <= EXT_SENSE_RES_SCALED_AIN)
	  {		msg_correct_cnt++; hstepmtr.standalone_cfg.current_setting = CAN_Rx_Data_Id2[2];	}
	  
	  if(CAN_Rx_Data_Id2[3] <= HYSTERESIS_END_13)
	  {		msg_correct_cnt++; hstepmtr.standalone_cfg.chopper_hysteresis = CAN_Rx_Data_Id2[3];	}
	  
	  if(CAN_Rx_Data_Id2[4] <= BLANK_TIME_36)
	  {		msg_correct_cnt++; hstepmtr.standalone_cfg.chopper_blank_time = CAN_Rx_Data_Id2[4];	}
	  
	  hstepmtr.standalone_cfg.driver_enable = CAN_Rx_Data_Id2[5] & DRIVER_DISABLE;
	  hstepmtr.standalone_cfg.standstill_pwr_down = CAN_Rx_Data_Id2[5] & STANDSTILL_ON;
	  
	  if(msg_correct_cnt > 0){
		  osSemaphoreRelease(myBinarySem04Handle);	// pass to the next task
	  }// if 0 (none) of the messages are correct, don't proceed
  }
  /* USER CODE END Interpret_CAN_Msg_Id2 */
}

/* USER CODE BEGIN Header_Update_Standalone_Op_Task */
/**
* @brief Function implementing the DeferredTask4 thread.
* @param argument: Not used
* @retval None
*/
/* USER CODE END Header_Update_Standalone_Op_Task */
void Update_Standalone_Op_Task(void *argument)
{
  /* USER CODE BEGIN Update_Standalone_Op_Task */
  /* Infinite loop */
  for(;;)
  {
	  osSemaphoreAcquire(myBinarySem04Handle, osWaitForever);
	  Update_Standalone_Configuration();
  }
  /* USER CODE END Update_Standalone_Op_Task */
}

/**
  * @brief  Period elapsed callback in non blocking mode
  * @note   This function is called  when TIM7 interrupt took place, inside
  * HAL_TIM_IRQHandler(). It makes a direct call to HAL_IncTick() to increment
  * a global variable "uwTick" used as application time base.
  * @param  htim : TIM handle
  * @retval None
  */
void HAL_TIM_PeriodElapsedCallback(TIM_HandleTypeDef *htim)
{
  if (htim->Instance == TIM7) {
    HAL_IncTick();
  }
}

/**
  * @brief  This function is executed in case of error occurrence.
  * @retval None
  */
void Error_Handler(void)
{
  /* USER CODE BEGIN Error_Handler_Debug */
  /* User can add his own implementation to report the HAL error return state */
  __disable_irq();
  while (1)
  {
  }
  /* USER CODE END Error_Handler_Debug */
}

#ifdef  USE_FULL_ASSERT
/**
  * @brief  Reports the name of the source file and the source line number
  *         where the assert_param error has occurred.
  * @param  file: pointer to the source file name
  * @param  line: assert_param error line source number
  * @retval None
  */
void assert_failed(uint8_t *file, uint32_t line)
{
  /* USER CODE BEGIN 6 */
  /* User can add his own implementation to report the file name and line number,
     ex: printf("Wrong parameters value: file %s on line %d\r\n", file, line) */
  /* USER CODE END 6 */
}
#endif /* USE_FULL_ASSERT */
