nvrmchng/stepper-trinamic/Firmware/Standalone_Test_2/Core/Inc/main.h

#define B1_Pin LL_GPIO_PIN_13
#define B1_GPIO_Port GPIOC
#define CFG5_Pin LL_GPIO_PIN_0
#define CFG5_GPIO_Port GPIOA
#define USART_TX_Pin LL_GPIO_PIN_2
#define USART_TX_GPIO_Port GPIOA
#define USART_RX_Pin LL_GPIO_PIN_3
#define USART_RX_GPIO_Port GPIOA
#define LD2_Pin LL_GPIO_PIN_5
#define LD2_GPIO_Port GPIOA
#define CFG4_Pin LL_GPIO_PIN_0
#define CFG4_GPIO_Port GPIOB
#define STEP_Pin LL_GPIO_PIN_10
#define STEP_GPIO_Port GPIOB
#define CFG3_Pin LL_GPIO_PIN_12
#define CFG3_GPIO_Port GPIOB
#define CFG2_Pin LL_GPIO_PIN_13
#define CFG2_GPIO_Port GPIOB
#define CFG0_Pin LL_GPIO_PIN_14
#define CFG0_GPIO_Port GPIOB
#define CFG1_Pin LL_GPIO_PIN_15
#define CFG1_GPIO_Port GPIOB
#define DIR_Pin LL_GPIO_PIN_8
#define DIR_GPIO_Port GPIOA
#define TMS_Pin LL_GPIO_PIN_13
#define TMS_GPIO_Port GPIOA
#define TCK_Pin LL_GPIO_PIN_14
#define TCK_GPIO_Port GPIOA
#define CFG6_EN_Pin LL_GPIO_PIN_11
#define CFG6_EN_GPIO_Port GPIOC
#define SWO_Pin LL_GPIO_PIN_3
#define SWO_GPIO_Port GPIOB
