nvrmchng/stepper-trinamic/Software ui/Qt (Linux BBB)/background.h

#ifndef BACKGROUND_H
#define BACKGROUND_H

#include <QWidget>

class Background : public QWidget
{
    Q_OBJECT

public:
    explicit Background(QWidget *parent = nullptr);
    ~Background();
    void setupUi();
};
#endif // WIDGET_H
