nvrmchng/stepper-trinamic/(commit log)

2024-09-15 Create Stepper_Motor_Expansion_Brd_revA-top-pos
2024-09-15 Update Stepper_Motor_Expansion_Brd_revA-top-pos
2024-09-15 add CTP_Display_CANbus_revA to PCB_Files
    [BOM_CTP_Display_CANbus_revA.xlsx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]
2024-09-15 Create RM0351-STM32L47xxx-STM32L48xxx-STM32L49xxx-and-STM32L4Axxx-(Reference Manual).pdf
2024-09-15 add some pictures of board
