nvrmchng/stepper-trinamic/(notices)

Notices in the files:
Firmware/Standalone_Test_2/Core/Src/main.c:
Copyright (c) 2024 STMicroelectronics.
All rights reserved.
This software is licensed under terms that can be found in the LICENSE file
